lukavidic/ColorSorter_B/images/ESP8266_ESP-01.png

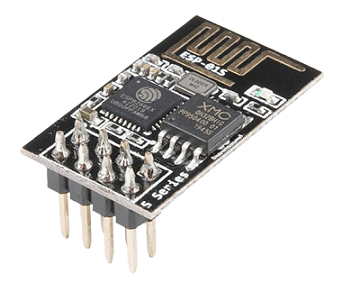
images/ESP8266_ESP-01.png
