lukavidic/ColorSorter_B/images/servo_motor.jpg

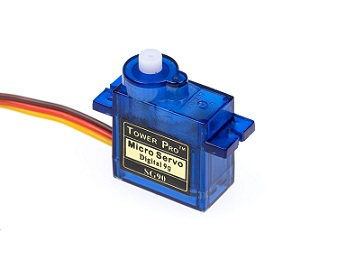
images/servo_motor.jpg
