lukavidic/ColorSorter_B/firmware/project/Doxygen/latex/topics.tex

\doxysection{Topics}
Here is a list of all topics with brief descriptions\+:\begin{DoxyCompactList}
\item \contentsline{section}{Servo Control}{\pageref{group__servo}}{}
\item \contentsline{section}{Wi-\/\+Fi / ESP8266}{\pageref{group__wifi}}{}
\item \contentsline{section}{Color Sensor \& Detection}{\pageref{group__color}}{}
\end{DoxyCompactList}
