lukavidic/ColorSorter_B/images/basic-configuration.png

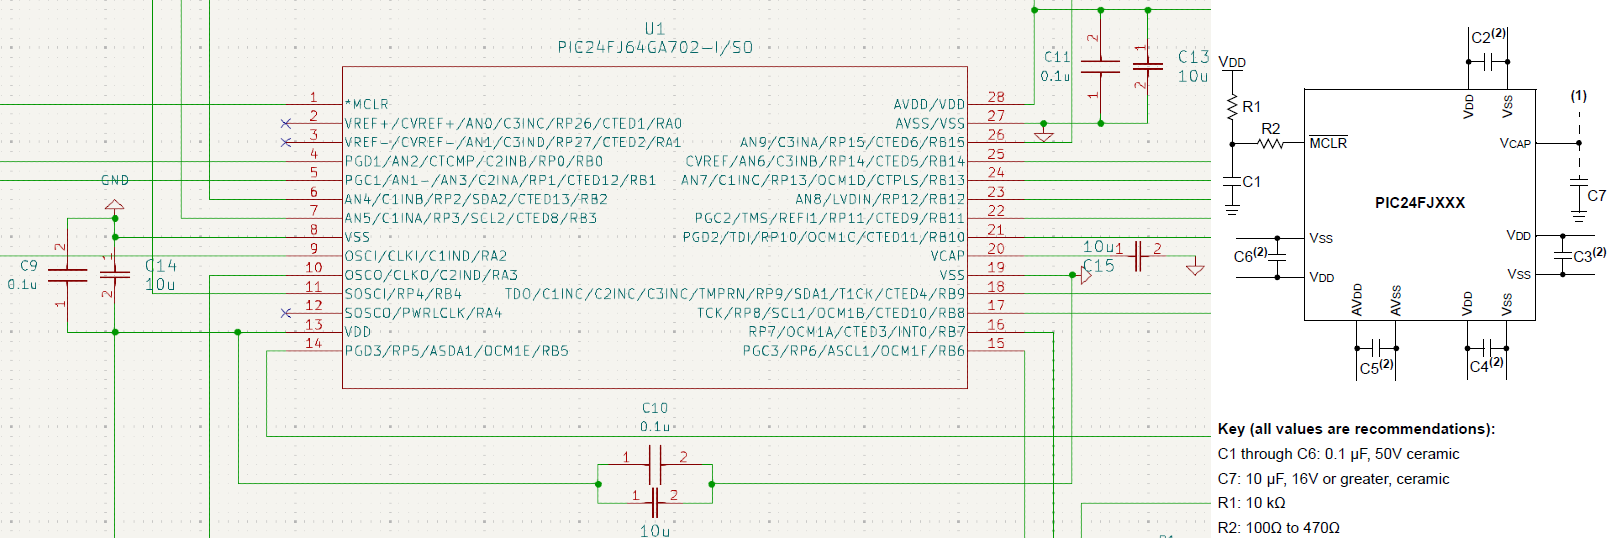
images/basic-configuration.png
