lukavidic/ColorSorter_B/images/Color 10 Click.png

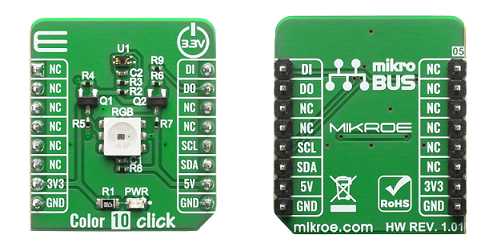
images/Color 10 Click.png
