lukavidic/ColorSorter_B/images/color_10_click.png

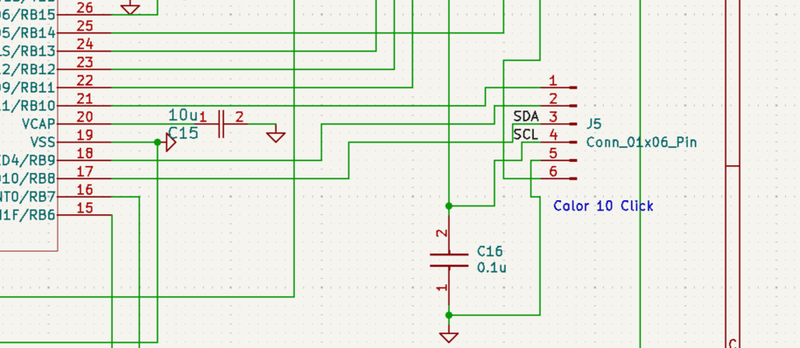
images/color_10_click.png
