lukavidic/ColorSorter_B/images/Color_10_Click_Scheme.png

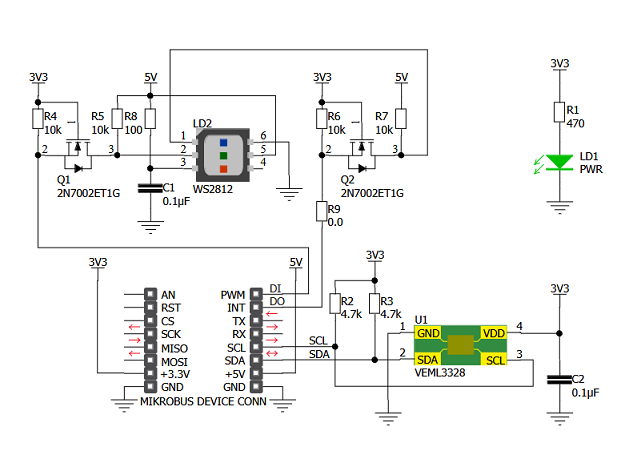
images/Color_10_Click_Scheme.png
