lukavidic/ColorSorter_B/images/HS-KEY1B key switch module.png

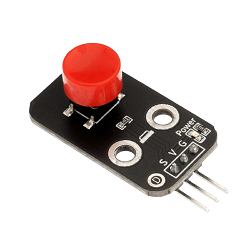
images/HS-KEY1B key switch module.png
