lukavidic/ColorSorter_B/images/LED.png

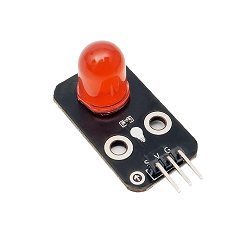
images/LED.png
