lukavidic/ColorSorter_B/images/oscillator.png

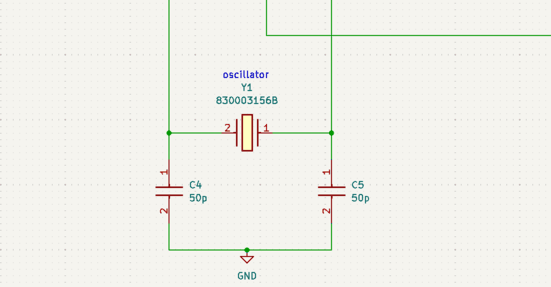
images/oscillator.png
