lukavidic/ColorSorter_B/images/pcb.PNG

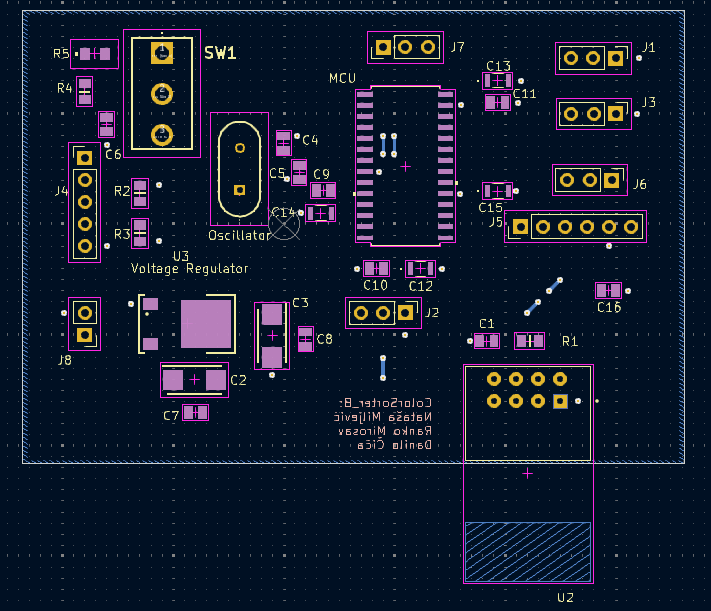
images/pcb.PNG
