lukavidic/ColorSorter_B/images/PIC24FJ64GA702.png

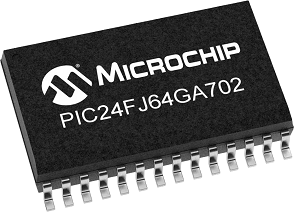
images/PIC24FJ64GA702.png
