lukavidic/ColorSorter_B/images/pickit3.png

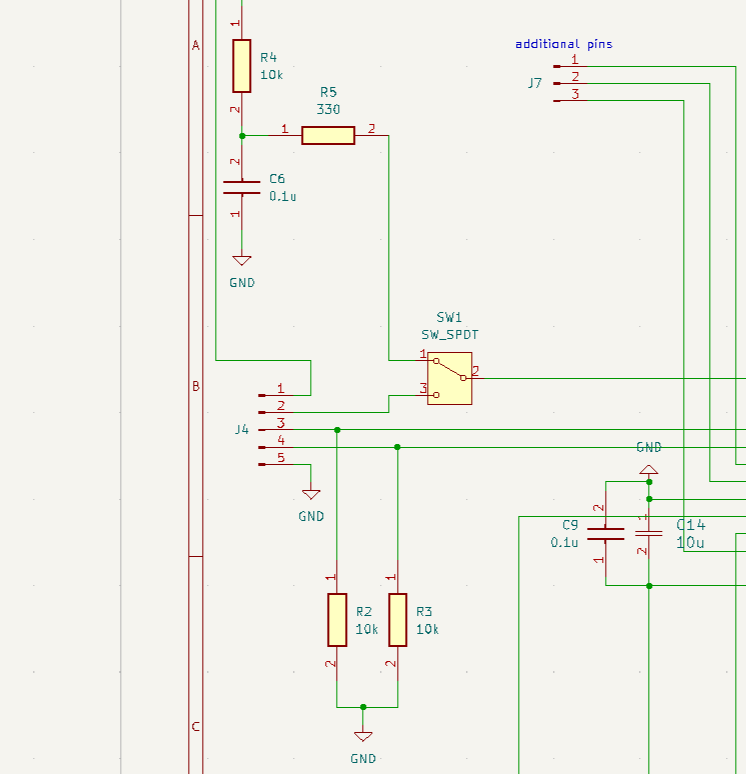
images/pickit3.png
