lukavidic/ColorSorter_B/images/PICKit_3.png

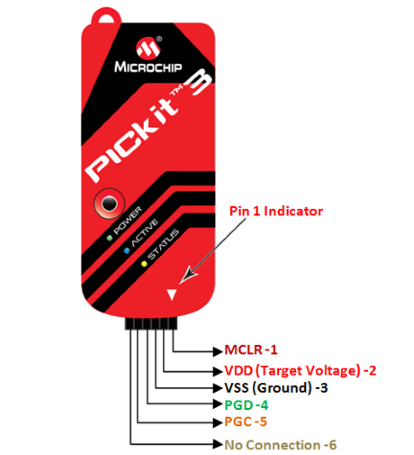
images/PICKit_3.png
