lukavidic/ColorSorter_B/images/Pin Diagram.PNG

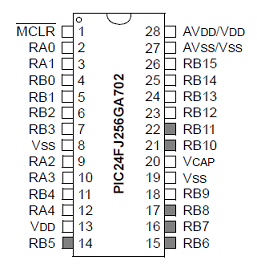
images/Pin Diagram.PNG
