lukavidic/ColorSorter_B/images/routed_pcb.PNG

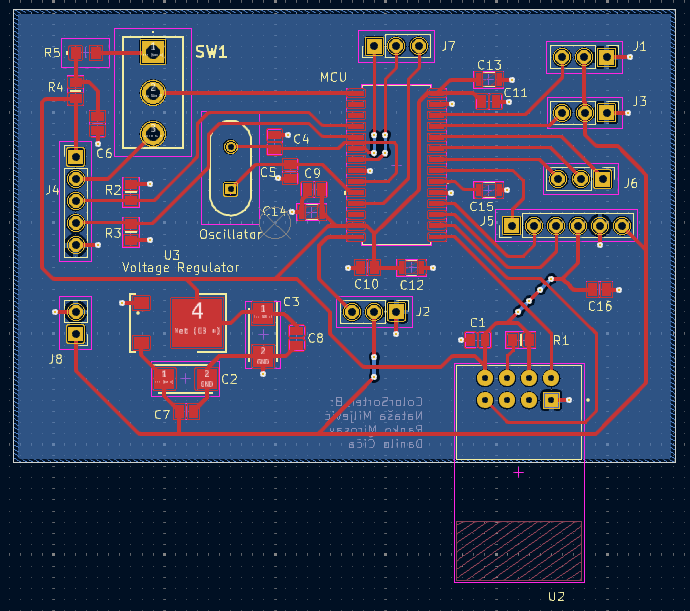
images/routed_pcb.PNG
