lukavidic/ColorSorter_B/images/schematic.PNG

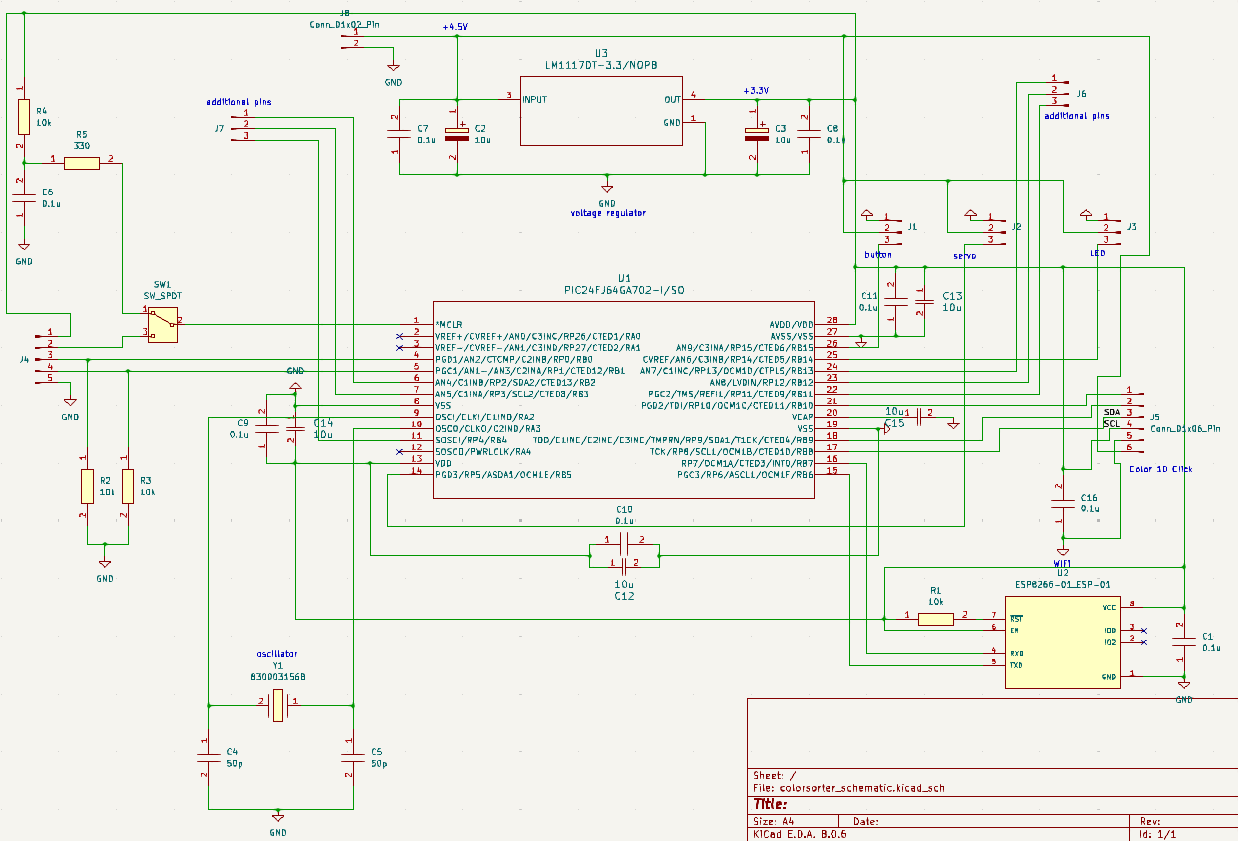
images/schematic.PNG
