lukavidic/ColorSorter_B/images/VEML3328_Scheme.png

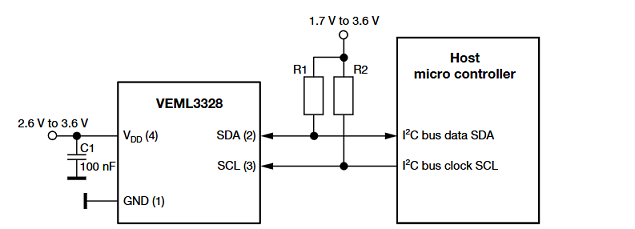
images/VEML3328_Scheme.png
