lukavidic/ColorSorter_B/images/voltage regulator.PNG

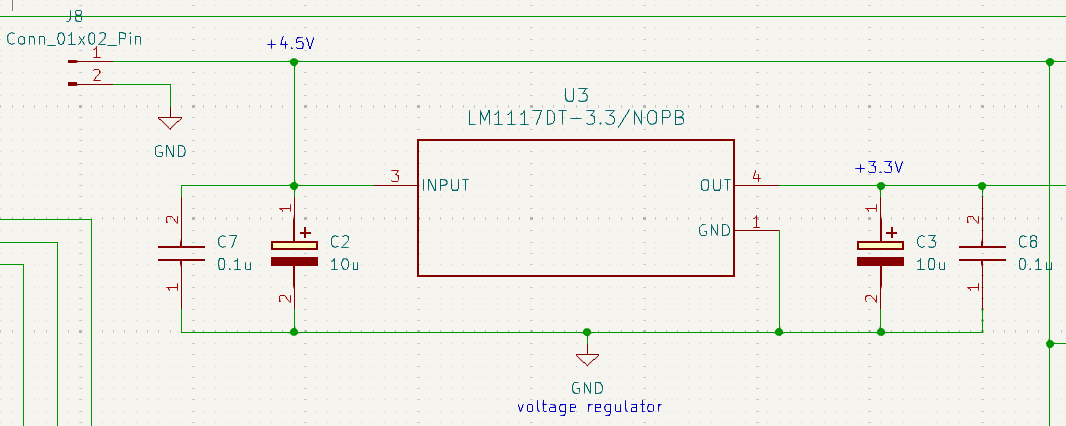
images/voltage regulator.PNG
