lukavidic/ColorSorter_B/images/Wi-Fi_pinouts.PNG

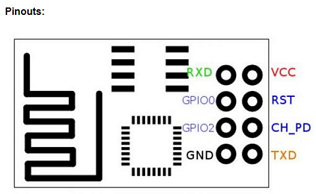
images/Wi-Fi_pinouts.PNG
