lukavidic/ColorSorter_B/images/wifi.PNG

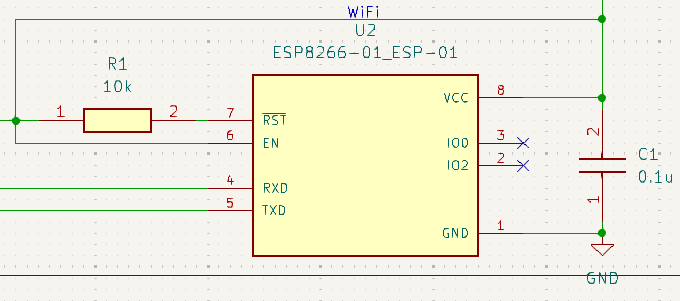
images/wifi.PNG
