lukavidic/ColorSorter_B/symbols_and_footprints/0.1uF/KAM21BR71H104JT/3D/KAM21BR71H104JT.stp

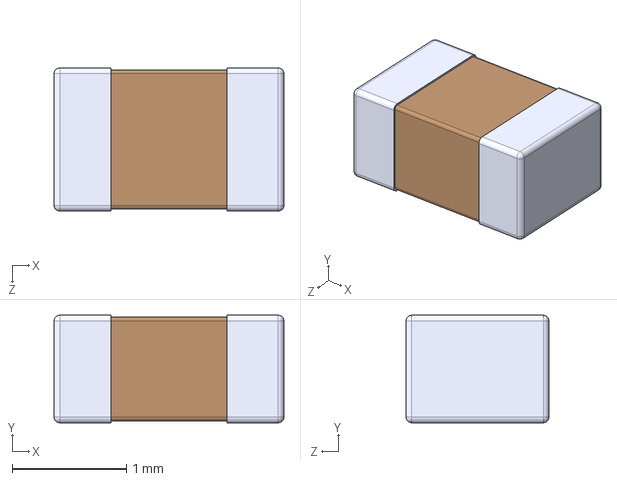
[picture p21: CAD file, 2024-12-25]
symbols_and_footprints/0.1uF/KAM21BR71H104JT/3D/KAM21BR71H104JT.stp
2.01 x 0.94 x 1.25 mm
