lukavidic/ColorSorter_B/symbols_and_footprints/10kohm/ERJ-S06F1002V/3D/ERJ-S06F1002V.stp

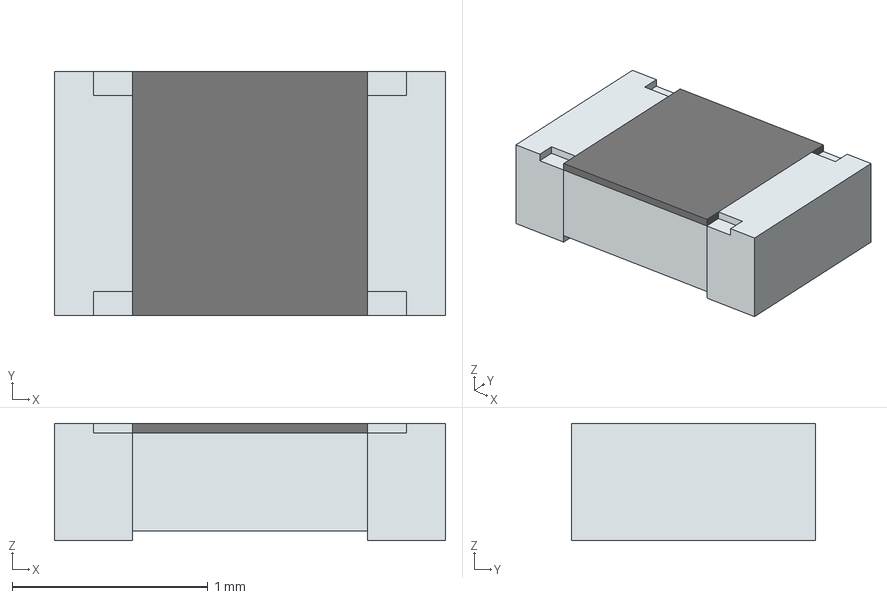
[picture p22: CAD file, 2024-12-25]
symbols_and_footprints/10kohm/ERJ-S06F1002V/3D/ERJ-S06F1002V.stp
2.00 x 1.25 x 0.6 mm
solidBody
Terminal
solidTop
