lukavidic/ColorSorter_B/symbols_and_footprints/10uF tantalum/293D106X9010C2TE3/3D/293D106X9010C2TE3.stp

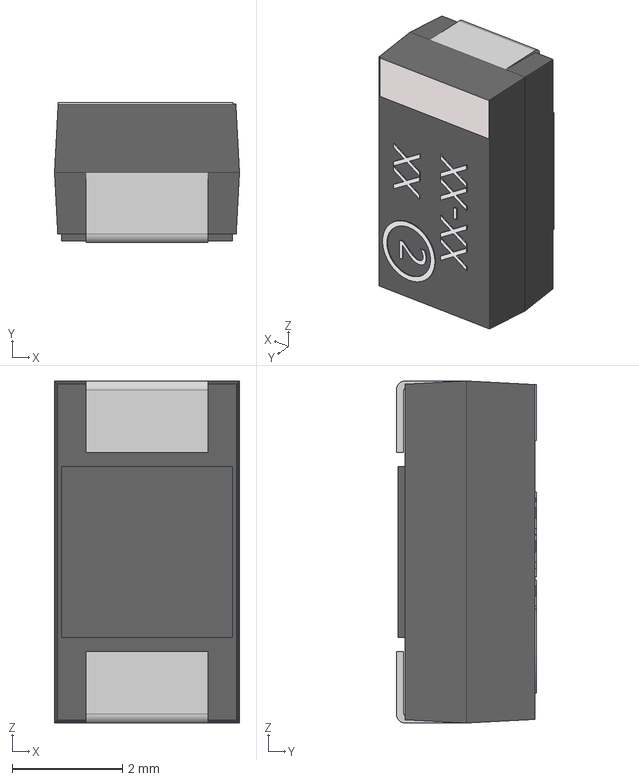
[picture p23: CAD file, 2024-12-25]
symbols_and_footprints/10uF tantalum/293D106X9010C2TE3/3D/293D106X9010C2TE3.stp
3.35 x 2.54 x 6.20 mm
