lukavidic/ColorSorter_B/symbols_and_footprints/330ohm/ERJ-P06D3300V/3D/ERJ-P06D3300V.stp

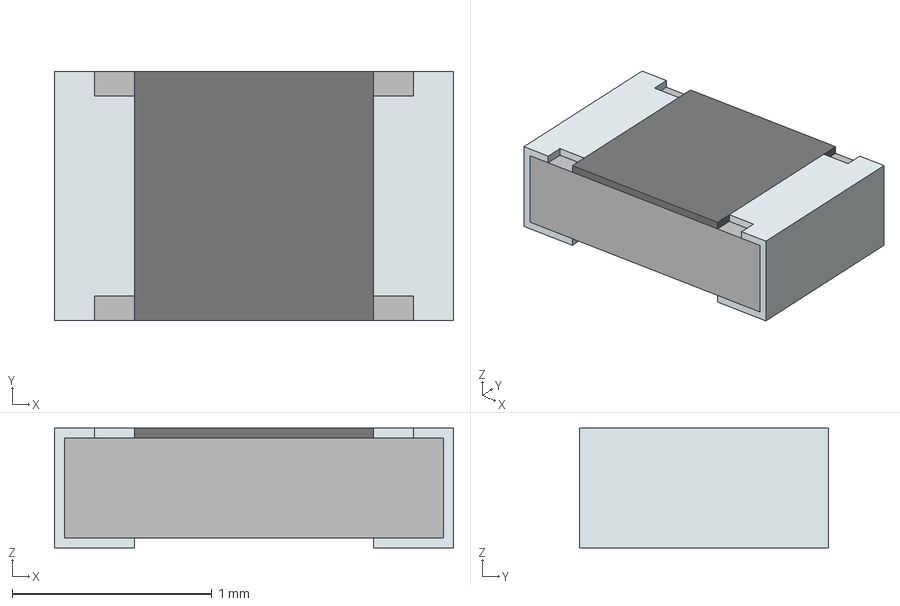
[picture p24: CAD file, 2024-12-25]
symbols_and_footprints/330ohm/ERJ-P06D3300V/3D/ERJ-P06D3300V.stp
2.00 x 1.25 x 0.6 mm
solidBody
Terminal
solidTop
