lukavidic/ColorSorter_B/symbols_and_footprints/ESP8266-01_ESP-01/ESP8266-01_ESP-01.step

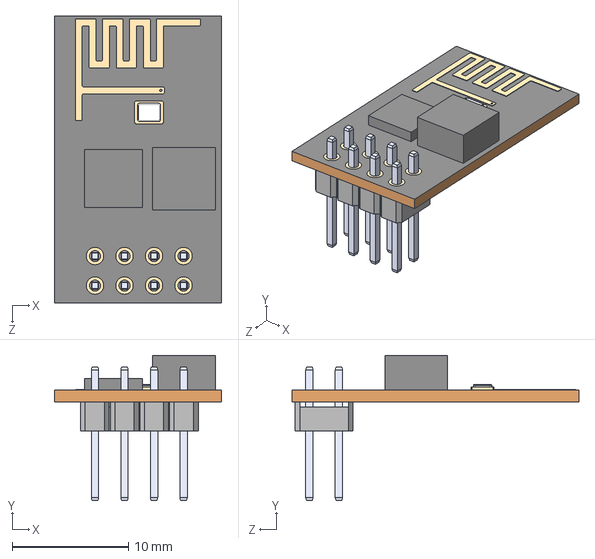
[picture p25: CAD file, 2024-12-10]
symbols_and_footprints/ESP8266-01_ESP-01/ESP8266-01_ESP-01.step
14.4 x 12.5 x 24.7 mm
