lukavidic/ColorSorter_B/symbols_and_footprints/switch/SLW-1276864-4A-D/3D/SLW-1276864-4A-D.stp

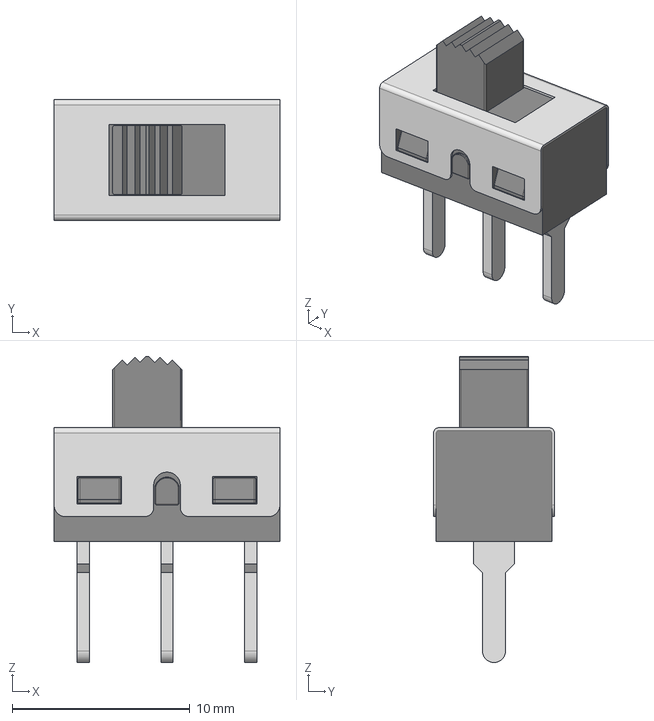
[picture p26: CAD file, 2024-12-25]
symbols_and_footprints/switch/SLW-1276864-4A-D/3D/SLW-1276864-4A-D.stp
12.7 x 6.80 x 17.2 mm
