lukavidic/ColorSorter_B/symbols_and_footprints/50pF/08055A500FAT2A/3D/08055A500FAT2A.stp

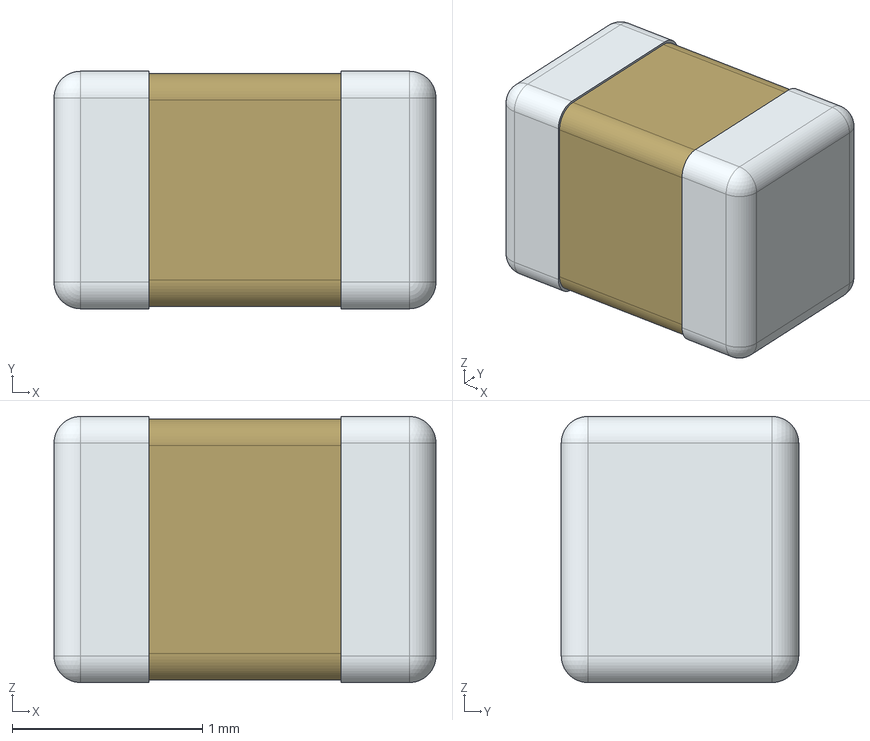
[picture p27: CAD file, 2024-12-25]
symbols_and_footprints/50pF/08055A500FAT2A/3D/08055A500FAT2A.stp
2.01 x 1.25 x 1.40 mm
