lukavidic/ColorSorter_B/symbols_and_footprints/LIB_830003156B/830003156B/3D/830003156B.stp

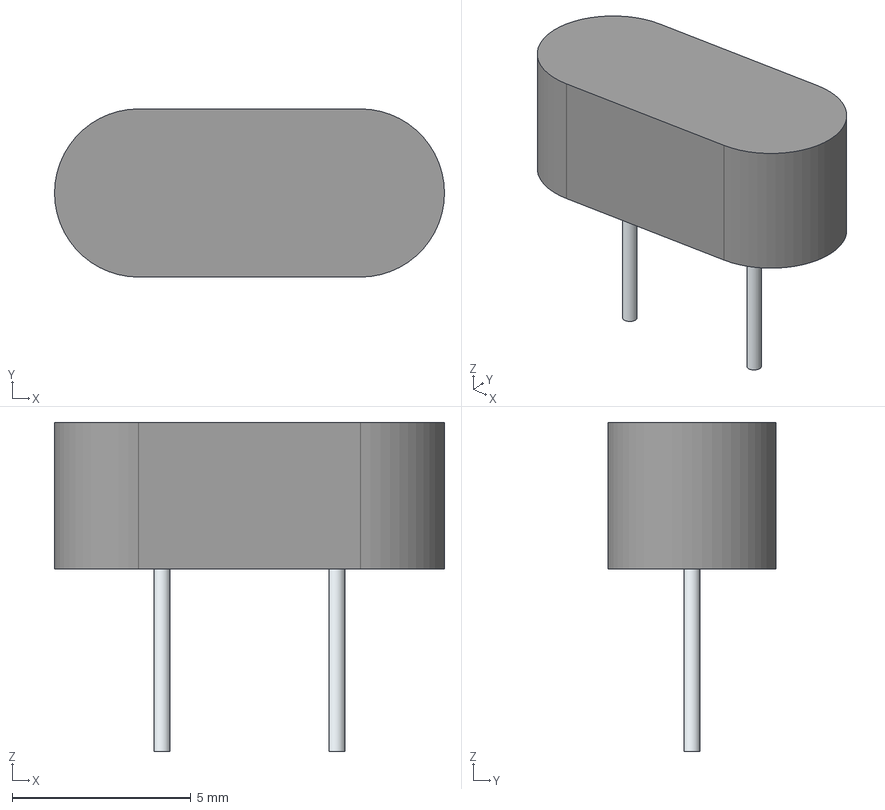
[picture p28: CAD file, 2024-12-25]
symbols_and_footprints/LIB_830003156B/830003156B/3D/830003156B.stp
10.9 x 4.70 x 9.20 mm
Leads
