lukavidic/ColorSorter_B/symbols_and_footprints/wifi female header/M20-7830446/3D/M20-7830446.stp

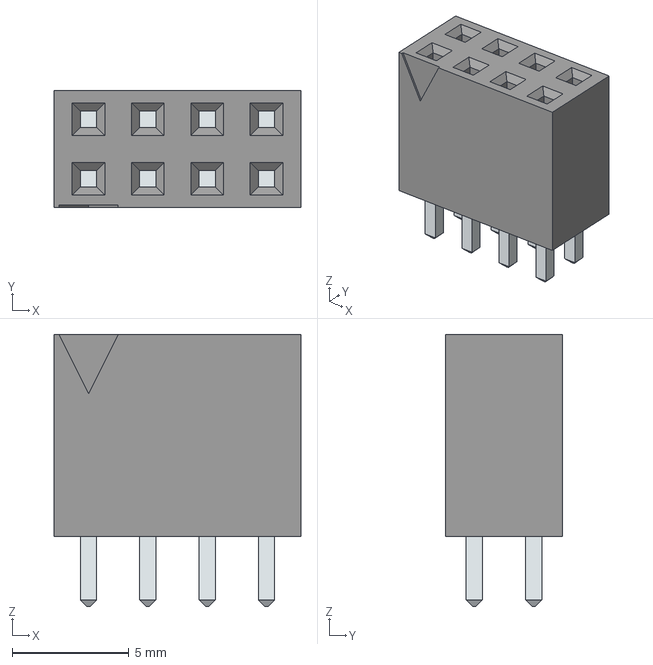
[picture p29: CAD file, 2024-12-25]
symbols_and_footprints/wifi female header/M20-7830446/3D/M20-7830446.stp
10.6 x 5.00 x 11.7 mm
LeadsArray
