lukavidic/ColorSorter_B/(list of files, cad)

Other CAD files:
symbols_and_footprints/0.1uF/KAM21BR71H104JT/Allegro/capc2012x94n.psm
symbols_and_footprints/0.1uF/KAM21BR71H104JT/DEHDL/kam21br71h104jt/chips/chips.prt
symbols_and_footprints/10kohm/ERJ-S06F1002V/Allegro/erjs06_u06__0805_.psm
symbols_and_footprints/10kohm/ERJ-S06F1002V/DEHDL/erj_s06f1002v/chips/chips.prt
symbols_and_footprints/10uF tantalum/293D106X9010C2TE3/Allegro/cappm6032x280n.psm
symbols_and_footprints/10uF tantalum/293D106X9010C2TE3/DEHDL/293d106x9010c2te3/chips/chips.prt
symbols_and_footprints/330ohm/ERJ-P06D3300V/Allegro/erjp06d1000v.psm
symbols_and_footprints/330ohm/ERJ-P06D3300V/DEHDL/erj_p06d3300v/chips/chips.prt
symbols_and_footprints/50pF/08055A500FAT2A/Allegro/capc2012x140n.psm
symbols_and_footprints/50pF/08055A500FAT2A/DEHDL/08055a500fat2a/chips/chips.prt
symbols_and_footprints/LIB_830003156B/830003156B/Allegro/830003156b.psm
symbols_and_footprints/LIB_830003156B/830003156B/DEHDL/830003156b/chips/chips.prt
symbols_and_footprints/switch/SLW-1276864-4A-D/Allegro/slw12768644ad.psm
symbols_and_footprints/switch/SLW-1276864-4A-D/DEHDL/slw_1276864_4a_d/chips/chips.prt
symbols_and_footprints/wifi female header/M20-7830446/Allegro/rhdr8w70p254x254_2x4_1056x500x865p.psm
symbols_and_footprints/wifi female header/M20-7830446/DEHDL/m20_7830446/chips/chips.prt
