lukavidic/ColorSorter_B/(threads)

Thread 2 (2024-11-11):

Issue #2 : Upoznavanje sa komponentama

natasamiljevic, 2024-11-11:
Upoznati se sa komponentama koje se koriste za realizaciju projekta:

- servomotor
- ace tracking sensor
- LED lights
- button
- battery case

rankomirosav, 2024-11-11:
Težina zadatka: 3

Chicha13, 2024-11-11:
Ocjena tezine (1-10):

4

natasamiljevic, 2024-11-11:
Težina zadatka na skali od 1 do 10 je 3.

Chicha13, 2024-11-18:
Završeno. Potrebno vrijeme: 1h 30min.

Closed 2024-11-18.

Thread 6 (2024-11-26):

Issue #6 : Projektovanje električne šeme - početna integracija MCU

natasamiljevic, 2024-11-26:
Ovaj issue se odnosi na početnu fazu projektovanja PCB-a za naš sistem, sa fokusom na integraciju mikrokontrolera PIC24FJ64GA702. Električna šema će biti dizajnirana u KiCad softveru, a cilj je projektovati osnovnu šemu sa mikrokontrolerom.

natasamiljevic, 2024-11-26:
Težina zadatka na skali od 1 do 10 je 9.

rankomirosav, 2024-11-27:
Tezina zadatka 9.

Chicha13, 2024-12-04:
Završeno. Potrebno vrijeme: 1h.

Closed 2024-12-04.

Thread 7 (2024-11-26):

Issue #7 : Analiza sistema za napajanje

natasamiljevic, 2024-11-26:
Koraci:
- Analiza strujnih i naponskih zahtjeva sistema.
- Izbor napajanja za mikrokontroler i komponente.
- Razmatranje baterija i naponskih regulatora.

natasamiljevic, 2024-11-26:
Težina zadatka na skali od 1 do 10 je 8.

rankomirosav, 2024-11-27:
Tezina zadatka je 7.

Chicha13, 2024-11-27:
Ocjena težine (1-10):

7

rankomirosav, 2024-11-27:
Potrebno vrijeme za izradu 2h.

Closed 2024-11-27.

Thread 13 (2024-12-04):

Issue #13 : Projektovanje električne šeme - servo motor

natasamiljevic, 2024-12-04:

natasamiljevic, 2024-12-04:
Težina zadatka na skali od 1 do 10 je 8.

rankomirosav, 2024-12-05:
Težina zadatka je 7.

Chicha13, 2024-12-10:
Ocjena težine (1-10):

7

natasamiljevic, 2024-12-10:
Završeno. Potrebno vrijeme: 10 minuta.

Closed 2024-12-10.

Thread 17 (2024-12-10):

Issue #17 : Projektovanje električne šeme - naponski regulator

natasamiljevic, 2024-12-10:

rankomirosav, 2024-12-10:
Tezina zadatka je 5.

Chicha13, 2024-12-10:
Ocjena težine (1-10):

6

natasamiljevic, 2024-12-25:
Završeno. Potrebno vrijeme: 3h.

Closed 2024-12-25.

Thread 18 (2024-12-10):

Issue #18 : Projektovanje električne šeme - LED

natasamiljevic, 2024-12-10:

natasamiljevic, 2024-12-10:
Težina zadatka na skali od 1 do 10 je 5.

rankomirosav, 2024-12-10:
Tezina zadatka je 5.

Chicha13, 2024-12-10:
Ocjena težine (1-10):

5

rankomirosav, 2024-12-10:
Vrijeme izrade zadatka je 30 m.

Closed 2024-12-10.

Thread 19 (2024-12-23):

Issue #19 : Projektovanje pcb-a

natasamiljevic, 2024-12-23:
Po završenom projektovanju električne šeme potrebno je projektovati štampanu pločicu. Projektovanje štampane pločice podrazumijeva i pronalazak svih odgovarajućih footprinta za komponente koje će se koristiti (mikrokontroler, wifi modul, naponski regulator, eksterni oscilator), te odabir odgovarajućih dimenzija za smd otpornike i kondenzatore i odabir konektora.

natasamiljevic, 2024-12-23:
Težina zadatka na skali od 1 do 10 je 8.

Chicha13, 2024-12-25:
Ocjena težine (1-10):

8

rankomirosav, 2024-12-25:
Tezina zadatka je 8.

natasamiljevic, 2025-02-16:
Završeno. Potrebno vrijeme je 5 dana.
(uključujući vrijeme potrebno za pretragu odgovarajućih komponenata, procjenu budžeta i uklapanje svega što je ovaj task uključivao - ne samo samog projektovanja u KiCad alatu)

Closed 2025-02-16.

Thread 22 (2025-03-04):

Issue #22: Testiranje povezivanja servo motora sa mikrokontrolerom

natasamiljevic, 2025-03-04:

Chicha13, 2025-03-20:
Težina zadatka (1-10) : 6

Chicha13, 2025-05-09:
Završeno. Potrebno vrijeme: 12h.

Closed 2025-05-07.

Thread 23 (2025-03-04):

Issue #23: Testiranje povezivanja Color 10 Click modula sa mikrokontrolerom

natasamiljevic, 2025-03-04:
- Provjera I2C komunikacije
- Provjera ispravnog rada senzora

natasamiljevic, 2025-03-12:
Težina zadatka (1-10): 10.

Chicha13, 2025-03-20:
Ocjena tezine (1-10):

10

natasamiljevic, 2025-05-02:
Završeno. Potrebno vrijeme za realizaciju: 7 dana.

Closed 2025-05-02.

Thread 24 (2025-03-04):

Issue #24: Testiranje povezivanja Wi-Fi modula sa mikrokontrolerom

natasamiljevic, 2025-03-04:
- Provjera serijske komunikacije (UART) između mikrokontrolera i ESP8266
- Testiranje osnovnih AT komandi

natasamiljevic, 2025-03-12:
Težina zadatka (1-10): 9.

Chicha13, 2025-03-20:
Ocjena tezine (1-10):

9

rankomirosav, 2025-05-07:
Tezina zadatka je 9.

Chicha13, 2025-05-09:
Završeno. Potrebno vrijeme: 20h.
