lukavidic/ColorSorter_B/(list of files, drawings)

Other design files:
symbols_and_footprints/0.1uF/KAM21BR71H104JT/Altium/CAPC2012X94N.PcbLib
symbols_and_footprints/0.1uF/KAM21BR71H104JT/Altium/KAM21BR71H104JT.SchLib
symbols_and_footprints/10kohm/ERJ-S06F1002V/Altium/ERJ-S06F1002V.SchLib
symbols_and_footprints/10kohm/ERJ-S06F1002V/Altium/RESC2012X70N.PcbLib
symbols_and_footprints/10uF tantalum/293D106X9010C2TE3/Altium/293D106X9010C2TE3.SchLib
symbols_and_footprints/10uF tantalum/293D106X9010C2TE3/Altium/CAPPM6032X280N.PcbLib
symbols_and_footprints/50pF/08055A500FAT2A/Altium/08055A500FAT2A.SchLib
symbols_and_footprints/50pF/08055A500FAT2A/Altium/CAPC2012X140N.PcbLib
symbols_and_footprints/330ohm/ERJ-P06D3300V/Altium/ERJ-P06D3300V.SchLib
symbols_and_footprints/330ohm/ERJ-P06D3300V/Altium/ERJP06D1000V.PcbLib
symbols_and_footprints/switch/SLW-1276864-4A-D/Altium/SLW12768644AD.PcbLib
symbols_and_footprints/switch/SLW-1276864-4A-D/Altium/SLW-1276864-4A-D.SchLib
symbols_and_footprints/wifi female header/M20-7830446/Altium/M20-7830446.SchLib
symbols_and_footprints/wifi female header/M20-7830446/Altium/RHDR8W70P254X254_2X4_1056X500X865P.PcbLib
