lukavidic/ColorSorter_B/colorsorter_schematic/colorsorter_schematic.kicad_pcb

## KiCad design colorsorter_schematic/colorsorter_schematic.kicad_pcb (2025-01-30)

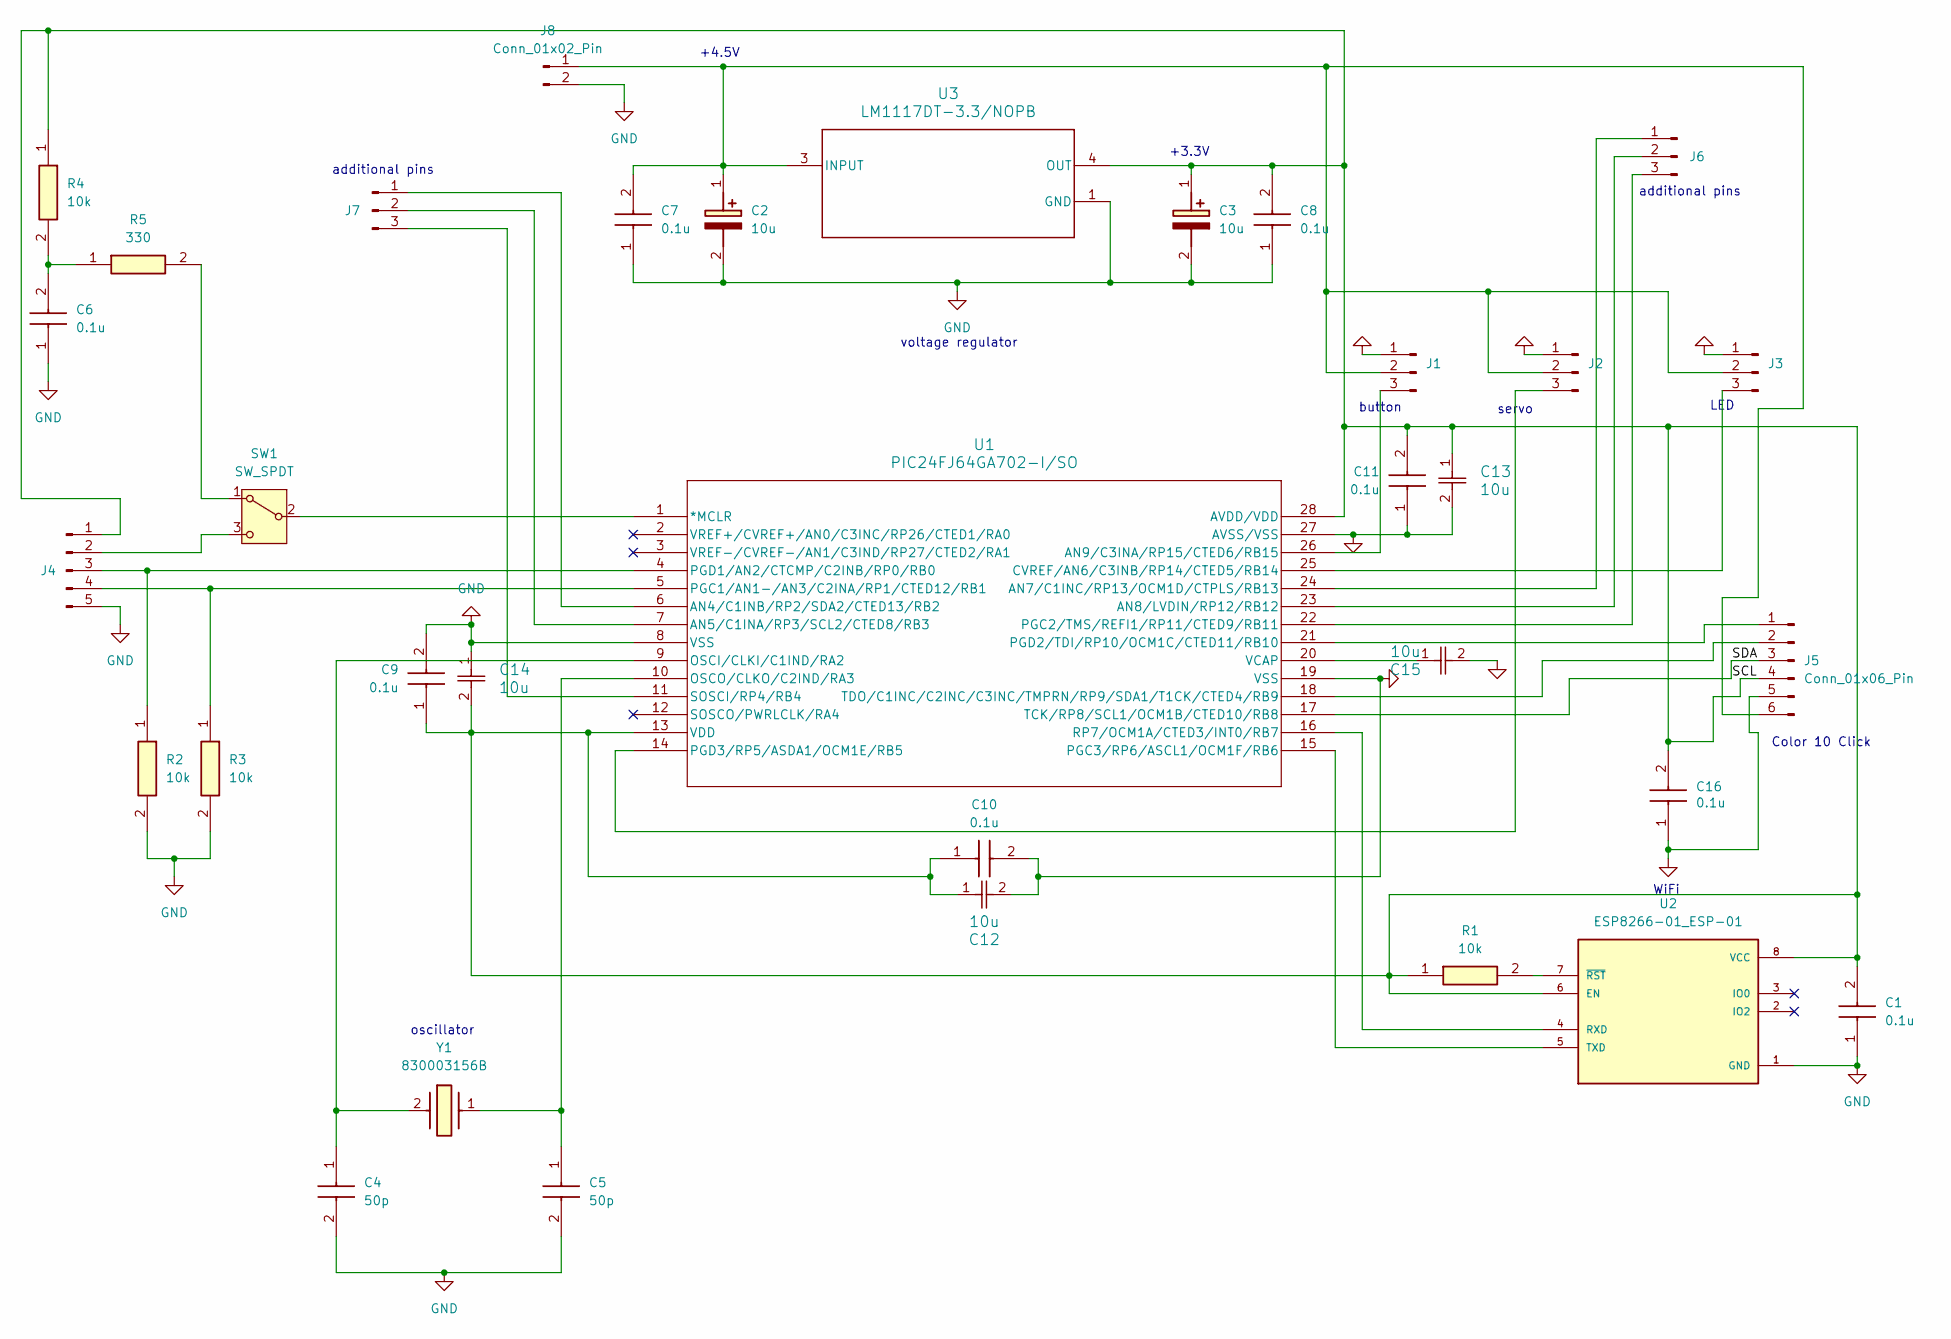
[picture p30: schematic colorsorter_schematic.kicad_sch]

Parts:
C1, C6, C7, C8, C9, C10, C11, C16: 0.1u; CAPC2012X94N; Manufacturer_Part_Number KAM21BR71H104JT; Mouser Part Number 581-KAM21BR71H104JT
C2, C3: 10u; CAPPM6032X280N; Manufacturer_Part_Number 293D106X9010C2TE3; Mouser Part Number 74-293D106X9010C2TE3
C4, C5: 50p; CAPC2012X140N; Manufacturer_Part_Number 08055A500FAT2A; Mouser Part Number 581-08055A500FAT2A
C12, C13, C14, C15: 10u; CAP_2012_TDK
J1, J2, J3, J6, J7: Conn_01x03_Pin; PinHeader_1x03_P2.54mm_Vertical
J4: Conn_01x05_Pin; PinHeader_1x05_P2.54mm_Vertical
J5: Conn_01x06_Pin; PinHeader_1x06_P2.54mm_Vertical
J8: Conn_01x02_Pin; PinHeader_1x02_P2.54mm_Vertical
R1, R2, R3, R4: 10k; RESC2012X70N; Manufacturer_Part_Number ERJ-S06F1002V; Mouser Part Number 667-ERJ-S06F1002V
R5: 330; ERJP06D1000V; Manufacturer_Part_Number ERJ-P06D3300V; Mouser Part Number 667-ERJ-P06D3300V
SW1: SW_SPDT; SLW12768644AD
U1: PIC24FJ64GA702-I/SO; SOIC28__SO28_MCH
U2: ESP8266-01_ESP-01; wifi; PARTREV V1.2
U3: LM1117DT-3.3/NOPB; NDP0003B
Y1: 830003156B; Manufacturer_Part_Number 830003156B; Mouser Part Number 710-830003156B

Connections:
/SCL: J5.3, U1.17 (TCK/RP8/SCL1/OCM1B/CTED10/RB8); also elsewhere on the board
GND: C1.1, C2.2 (-), C3.2 (-), C4.2, C5.2, C6.1, C7.1, C8.1, C9.2, C10.2, C11.1, C12.2, C13.2, C14.1, C15.2, C16.1, J1.1, J2.1, J3.1, J4.5, J5.5, J8.2, R2.2, R3.2, U1.8 (VSS), U1.19 (VSS), U1.27 (AVSS/VSS), U2.1 (GND), U3.1 (GND); also elsewhere on the board
unnamed: C2.1 (+), C7.2, J1.2, J2.2, J3.2, J5.6, J8.1, U3.3 (INPUT)
unnamed 3: C1.2, C3.1 (+), C8.2, C9.1, C10.1, C11.2, C12.1, C13.1, C14.2, C16.2, J4.1, J5.4, R1.1, R4.1, U1.13 (VDD), U1.28 (AVDD/VDD), U2.6 (EN), U2.8 (VCC), U3.4 (OUT); also elsewhere on the board
unnamed: C6.2, R4.2, R5.1
unnamed 5: J1.3, U1.26 (AN9/C3INA/RP15/CTED6/RB15); also elsewhere on the board
unnamed 6: J2.3, U1.14 (PGD3/RP5/ASDA1/OCM1E/RB5); also elsewhere on the board
unnamed 7: J3.3, U1.25 (CVREF/AN6/C3INB/RP14/CTED5/RB14); also elsewhere on the board
unnamed: J4.2, SW1.3 (C)
unnamed 9: J4.3, R2.1, U1.4 (PGD1/AN2/CTCMP/C2INB/RP0/RB0); also elsewhere on the board
unnamed 10: J4.4, R3.1, U1.5 (PGC1/AN1-/AN3/C2INA/RP1/CTED12/RB1); also elsewhere on the board
unnamed 11: J5.1, U1.21 (PGD2/TDI/RP10/OCM1C/CTED11/RB10); also elsewhere on the board
unnamed 12: J5.2, U1.18 (TDO/C1INC/C2INC/C3INC/TMPRN/RP9/SDA1/T1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); also elsewhere on the board
unnamed 13: J6.1, U1.24 (AN7/C1INC/RP13/OCM1D/CTPLS/RB13); also elsewhere on the board
unnamed 14: J6.2, U1.23 (AN8/LVDIN/RP12/RB12); also elsewhere on the board
unnamed 15: J6.3, U1.22 (PGC2/TMS/REFI1/RP11/CTED9/RB11); also elsewhere on the board
unnamed 16: J7.1, U1.6 (AN4/C1INB/RP2/SDA2/CTED13/RB2); also elsewhere on the board
unnamed 17: J7.2, U1.7 (AN5/C1INA/RP3/SCL2/CTED8/RB3); also elsewhere on the board
unnamed 18: J7.3, U1.11 (SOSCI/RP4/RB4); also elsewhere on the board
unnamed: R5.2, SW1.1 (A)
unnamed 20: SW1.2 (B), U1.1 (*MCLR); also elsewhere on the board
unnamed 21: C4.1, U1.9 (OSCI/CLKI/C1IND/RA2), Y1.2 (CRYSTAL_2); also elsewhere on the board
unnamed 22: C5.1, U1.10 (OSCO/CLKO/C2IND/RA3), Y1.1; also elsewhere on the board
unnamed 23: U1.15 (PGC3/RP6/ASCL1/OCM1F/RB6), U2.5 (TXD); also elsewhere on the board
unnamed 24: U1.16 (RP7/OCM1A/CTED3/INT0/RB7), U2.4 (RXD); also elsewhere on the board
unnamed 25: C15.1, U1.20 (VCAP); also elsewhere on the board
unnamed: R1.2, U2.7 (~RST)

Notes on the sheet:
additional pins
LED
oscillator
+3.3V
+4.5V
servo
WiFi
voltage regulator
button
Color 10 Click

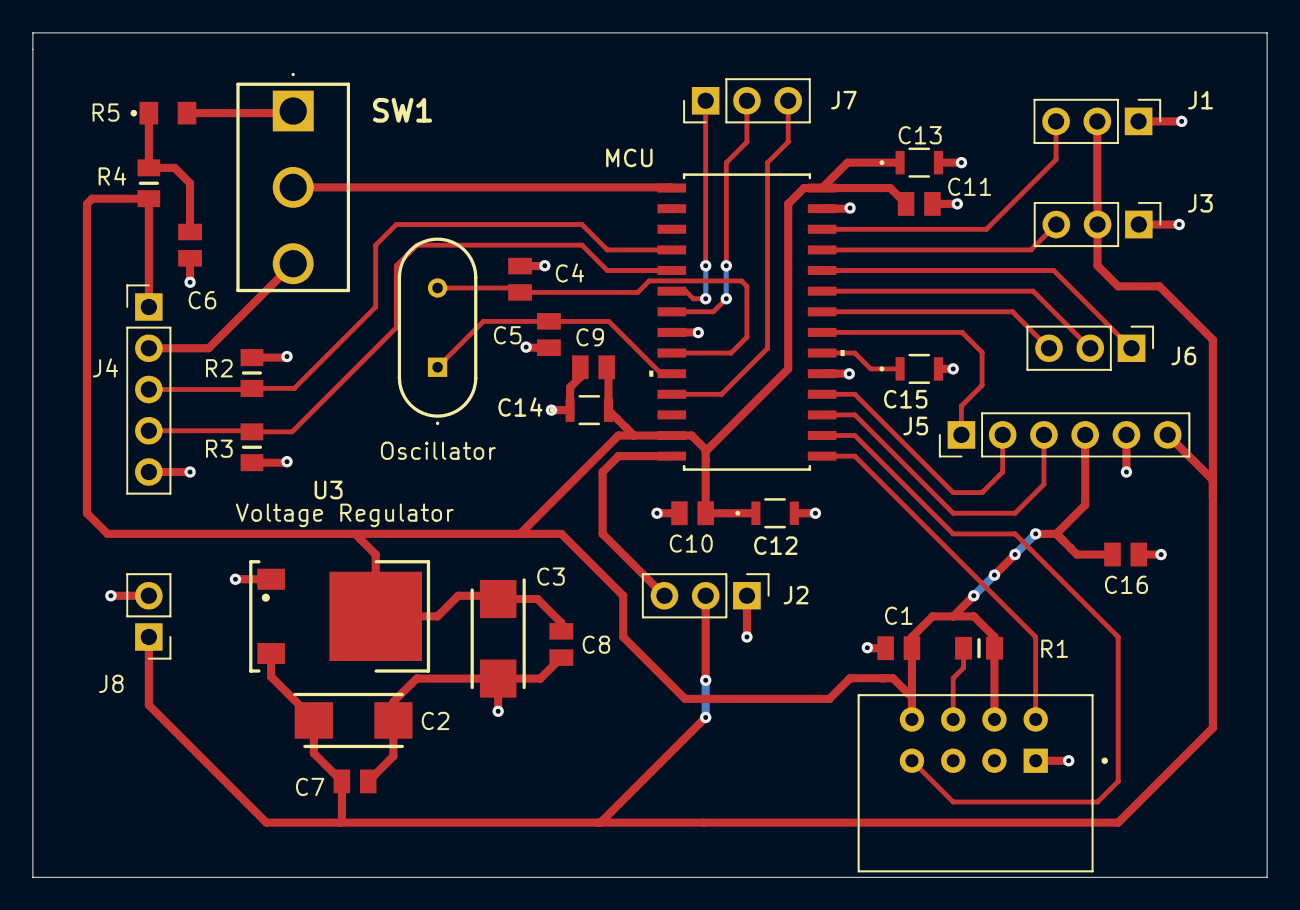
[picture p31: board colorsorter_schematic.kicad_pcb from above]

Board: 2 copper layers, 76.0 x 52.0 mm, 34 parts (0 on the bottom side), 27 nets.

Other parts of the board:
MCU: PIC24FJ64GA702-I/SO; SOIC28__SO28_MCH
Oscillator: 830003156B

Their connections:
/SCL: MCU.17 (TCK/RP8/SCL1/OCM1B/CTED10/RB8); also elsewhere on the board
GND: MCU.8 (VSS), MCU.19 (VSS), MCU.27 (AVSS/VSS); also elsewhere on the board
unnamed 3: MCU.13 (VDD), MCU.28 (AVDD/VDD); also elsewhere on the board
unnamed 5: MCU.26 (AN9/C3INA/RP15/CTED6/RB15); also elsewhere on the board
unnamed 6: MCU.14 (PGD3/RP5/ASDA1/OCM1E/RB5); also elsewhere on the board
unnamed 7: MCU.25 (CVREF/AN6/C3INB/RP14/CTED5/RB14); also elsewhere on the board
unnamed 9: MCU.4 (PGD1/AN2/CTCMP/C2INB/RP0/RB0); also elsewhere on the board
unnamed 10: MCU.5 (PGC1/AN1-/AN3/C2INA/RP1/CTED12/RB1); also elsewhere on the board
unnamed 11: MCU.21 (PGD2/TDI/RP10/OCM1C/CTED11/RB10); also elsewhere on the board
unnamed 12: MCU.18 (TDO/C1INC/C2INC/C3INC/TMPRN/RP9/SDA1/T1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); also elsewhere on the board
unnamed 13: MCU.24 (AN7/C1INC/RP13/OCM1D/CTPLS/RB13); also elsewhere on the board
unnamed 14: MCU.23 (AN8/LVDIN/RP12/RB12); also elsewhere on the board
unnamed 15: MCU.22 (PGC2/TMS/REFI1/RP11/CTED9/RB11); also elsewhere on the board
unnamed 16: MCU.6 (AN4/C1INB/RP2/SDA2/CTED13/RB2); also elsewhere on the board
unnamed 17: MCU.7 (AN5/C1INA/RP3/SCL2/CTED8/RB3); also elsewhere on the board
unnamed 18: MCU.11 (SOSCI/RP4/RB4); also elsewhere on the board
unnamed 20: MCU.1 (*MCLR); also elsewhere on the board
unnamed 21: MCU.9 (OSCI/CLKI/C1IND/RA2), Oscillator.2 (CRYSTAL_2); also elsewhere on the board
unnamed 22: MCU.10 (OSCO/CLKO/C2IND/RA3), Oscillator.1; also elsewhere on the board
unnamed 23: MCU.15 (PGC3/RP6/ASCL1/OCM1F/RB6); also elsewhere on the board
unnamed 24: MCU.16 (RP7/OCM1A/CTED3/INT0/RB7); also elsewhere on the board
unnamed 25: MCU.20 (VCAP); also elsewhere on the board
