lukavidic/ColorSorter_B/firmware/project/color_sorter.X/mcc_generated_files/pin_manager.h

/**
  PIN MANAGER Generated Driver File

  @Company:
    Microchip Technology Inc.

  @File Name:
    pin_manager.h

  @Summary:
    This is the generated manager file for the PIC24 / dsPIC33 / PIC32MM MCUs device.  This manager
    configures the pins direction, initial state, analog setting.
    The peripheral pin select, PPS, configuration is also handled by this manager.

  @Description:
    This source file provides implementations for PIN MANAGER.
    Generation Information :
        Product Revision  :  PIC24 / dsPIC33 / PIC32MM MCUs - 1.171.5
        Device            :  PIC24FJ64GA702
    The generated drivers are tested against the following:
        Compiler          :  XC16 v2.10
        MPLAB 	          :  MPLAB X v6.05
*/

/*
    (c) 2020 Microchip Technology Inc. and its subsidiaries. You may use this
    software and any derivatives exclusively with Microchip products.

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
    IN NO EVENT WILL MICROCHIP BE LIABLE FOR ANY INDIRECT, SPECIAL, PUNITIVE,
    INCIDENTAL OR CONSEQUENTIAL LOSS, DAMAGE, COST OR EXPENSE OF ANY KIND
    WHATSOEVER RELATED TO THE SOFTWARE, HOWEVER CAUSED, EVEN IF MICROCHIP HAS
    BEEN ADVISED OF THE POSSIBILITY OR THE DAMAGES ARE FORESEEABLE. TO THE
    FULLEST EXTENT ALLOWED BY LAW, MICROCHIP'S TOTAL LIABILITY ON ALL CLAIMS IN
    ANY WAY RELATED TO THIS SOFTWARE WILL NOT EXCEED THE AMOUNT OF FEES, IF ANY,
    THAT YOU HAVE PAID DIRECTLY TO MICROCHIP FOR THIS SOFTWARE.

    MICROCHIP PROVIDES THIS SOFTWARE CONDITIONALLY UPON YOUR ACCEPTANCE OF THESE
    TERMS.
*/

#ifndef _PIN_MANAGER_H
#define _PIN_MANAGER_H
/**
    Section: Includes
*/
#include <xc.h>

/**
    Section: Device Pin Macros
*/
/**
  @Summary
    Sets the GPIO pin, RB10, high using LATB10.

  @Description
    Sets the GPIO pin, RB10, high using LATB10.

  @Preconditions
    The RB10 must be set to an output.

  @Returns
    None.

  @Param
    None.

  @Example
    <code>
    // Set RB10 high (1)
    SDO1_SetHigh();
    </code>

*/
#define SDO1_SetHigh()          (_LATB10 = 1)
/**
  @Summary
    Sets the GPIO pin, RB10, low using LATB10.

  @Description
    Sets the GPIO pin, RB10, low using LATB10.

  @Preconditions
    The RB10 must be set to an output.

  @Returns
    None.

  @Param
    None.

  @Example
    <code>
    // Set RB10 low (0)
    SDO1_SetLow();
    </code>

*/
#define SDO1_SetLow()           (_LATB10 = 0)
/**
  @Summary
    Toggles the GPIO pin, RB10, using LATB10.

  @Description
    Toggles the GPIO pin, RB10, using LATB10.

  @Preconditions
    The RB10 must be set to an output.

  @Returns
    None.

  @Param
    None.

  @Example
    <code>
    // Toggle RB10
    SDO1_Toggle();
    </code>

*/
#define SDO1_Toggle()           (_LATB10 ^= 1)
/**
  @Summary
    Reads the value of the GPIO pin, RB10.

  @Description
    Reads the value of the GPIO pin, RB10.

  @Preconditions
    None.

  @Returns
    None.

  @Param
    None.

  @Example
    <code>
    uint16_t portValue;

    // Read RB10
    postValue = SDO1_GetValue();
    </code>

*/
#define SDO1_GetValue()         _RB10
/**
  @Summary
    Configures the GPIO pin, RB10, as an input.

  @Description
    Configures the GPIO pin, RB10, as an input.

  @Preconditions
    None.

  @Returns
    None.

  @Param
    None.

  @Example
    <code>
    // Sets the RB10 as an input
    SDO1_SetDigitalInput();
    </code>

*/
#define SDO1_SetDigitalInput()  (_TRISB10 = 1)
/**
  @Summary
    Configures the GPIO pin, RB10, as an output.

  @Description
    Configures the GPIO pin, RB10, as an output.

  @Preconditions
    None.

  @Returns
    None.

  @Param
    None.

  @Example
    <code>
    // Sets the RB10 as an output
    SDO1_SetDigitalOutput();
    </code>

*/
#define SDO1_SetDigitalOutput() (_TRISB10 = 0)
/**
  @Summary
    Sets the GPIO pin, RB11, high using LATB11.

  @Description
    Sets the GPIO pin, RB11, high using LATB11.

  @Preconditions
    The RB11 must be set to an output.

  @Returns
    None.

  @Param
    None.

  @Example
    <code>
    // Set RB11 high (1)
    SCK1OUT_SetHigh();
    </code>

*/
#define SCK1OUT_SetHigh()          (_LATB11 = 1)
/**
  @Summary
    Sets the GPIO pin, RB11, low using LATB11.

  @Description
    Sets the GPIO pin, RB11, low using LATB11.

  @Preconditions
    The RB11 must be set to an output.

  @Returns
    None.

  @Param
    None.

  @Example
    <code>
    // Set RB11 low (0)
    SCK1OUT_SetLow();
    </code>

*/
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

  @Preconditions
    None.

  @Returns
    None.

  @Param
    None.

  @Example
    <code>
    // Sets the RB5 as an input
    IO_RB5_SetDigitalInput();
    </code>

*/
#define IO_RB5_SetDigitalInput()  (_TRISB5 = 1)
/**
  @Summary
    Configures the GPIO pin, RB5, as an output.

  @Description
    Configures the GPIO pin, RB5, as an output.

  @Preconditions
    None.

  @Returns
    None.

  @Param
    None.

  @Example
    <code>
    // Sets the RB5 as an output
    IO_RB5_SetDigitalOutput();
    </code>

*/
#define IO_RB5_SetDigitalOutput() (_TRISB5 = 0)

/**
    Section: Function Prototypes
*/
/**
  @Summary
    Configures the pin settings of the PIC24FJ64GA702
    The peripheral pin select, PPS, configuration is also handled by this manager.

  @Description
    This is the generated manager file for the PIC24 / dsPIC33 / PIC32MM MCUs device.  This manager
    configures the pins direction, initial state, analog setting.
    The peripheral pin select, PPS, configuration is also handled by this manager.

  @Preconditions
    None.

  @Returns
    None.

  @Param
    None.

  @Example
    <code>
    void SYSTEM_Initialize(void)
    {
        // Other initializers are called from this function
        PIN_MANAGER_Initialize();
    }
    </code>

*/
void PIN_MANAGER_Initialize (void);



#endif
