lukavidic/ColorSorter_B/(commit log)

2024-11-27 Added button image
2024-11-27 Added Led Diode image
2024-12-04 Added mcu pin diagram for Wiki.
2024-12-04 Added Servo motor picture for Wiki.
2024-12-10 Issue #11 and #16: Added KiCad files.
    [colorsorter_schematic.kicad_pcb, colorsorter_schematic.kicad_sch]
2024-12-10 Issue #10 : Projektovanje električne šeme - minimalni broj pinova
    [colorsorter_schematic.kicad_sch]
2024-12-10 Issue #14 : Projektovanje električne šeme - taster
    [colorsorter_schematic.kicad_sch]
2024-12-10 Simbols and footprints used in KiCad.
    [ESP8266-01_ESP-01.step]
2024-12-10 Issue #13 : Projektovanje električne šeme - servo motor
    [colorsorter_schematic.kicad_sch]
2024-12-10 Issue #18:
    [colorsorter_schematic.kicad_sch]
2024-12-10 Issue #18: Projektovanje elektricne seme-LED
2024-12-10 Issue #17 : Projektovanje električne šeme - naponski regulator - potencijalna komponenta.
2024-12-11 Issue #15 : Konfiguracija oscilatora
    [colorsorter_schematic.kicad_sch]
2024-12-25 Added oscillator and voltage regulator datasheets.
2024-12-25 Deleted unused files from voltage_regulator directory
2024-12-25 Added capacitors, resistors, voltage regulator and oscillator symbols and footprints.
    [08055A500FAT2A.SchLib, 08055A500FAT2A.stp, 293D106X9010C2TE3.SchLib, 293D106X9010C2TE3.stp, 830003156B.stp, 830003156b.psm, CAPC2012X140N.PcbLib, CAPC2012X94N.PcbLib]
2024-12-25 Added voltage regulator, oscillator and bulk capacitors.
    [colorsorter_schematic.kicad_pcb, colorsorter_schematic.kicad_sch]
2024-12-25 Correction - added ground to WiFi module pin.
    [colorsorter_schematic.kicad_sch]
2024-12-25 Added additional pins header.
    [colorsorter_schematic.kicad_pcb, colorsorter_schematic.kicad_sch]
2025-01-15 Dodavanje izmjena u semi i rutranje na pcb
    [colorsorter_schematic.kicad_pcb, colorsorter_schematic.kicad_sch]
2025-01-15 Updated schematic.
    [ESP8266-01_ESP-01.step, colorsorter_schematic.kicad_sch]
2025-01-15 Updated schematic and pcb.
    [ESP8266-01_ESP-01.step, colorsorter_schematic.kicad_pcb, colorsorter_schematic.kicad_sch]
2025-01-15 Schematics Updated 15/1/2025
    [colorsorter_schematic.kicad_pcb]
2025-01-16 Popravljena verzija pcb-a.
    [colorsorter_schematic.kicad_pcb]
2025-01-23 J5 conn changed from 5 pin to 6 pin - updated pcb
2025-01-23 J5 conn changed from 5 pin to 6 pin - updated pcb - saved changes
    [colorsorter_schematic.kicad_pcb, colorsorter_schematic.kicad_sch]
2025-01-23 Dodavanje izmjena na pcb projekta
    [colorsorter_schematic.kicad_pcb, colorsorter_schematic.kicad_sch]
2025-01-28 Dodavanje izmjena na pcb fajlu.
    [colorsorter_schematic.kicad_pcb]
2025-01-28 Final version PCB and manufacturing files
    [bom.csv, colorsorter_schematic.kicad_pcb, colorsorter_schematic.kicad_sch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]
2025-01-30 Added manufaturing and fabrication files
    [colorsorter_schematic-B_Cu.gbl, colorsorter_schematic-B_Mask.gbs, colorsorter_schematic-B_Paste.gbp, colorsorter_schematic-B_Silkscreen.gbo, colorsorter_schematic-Edge_Cuts.gm1, colorsorter_schematic-F_Cu.gtl, colorsorter_schematic-F_Mask.gts, colorsorter_schematic-F_Paste.gtp]
2025-02-12 Dodavanje tekstualnih izmjena na semi.
    [colorsorter_schematic.kicad_sch]
2025-02-16 Images used for electrical schematic documentation.
2025-02-16 Images used for PCB documentation.
2025-03-04 Issue #21: .c and .hex files for initial testing
    [led_button_test.c]
2025-03-20 Issue #22: Testiranje povezivanja servo motora sa mikrokontrolerom
    Added testing code for servo functionality to verify PWM output and angle mapping
    [servo.c]
2025-05-02 Issue #23: Color sensor reading - test program with calibration.
2025-05-08 Changes to the wiki page Electrical Schematic Design
